sprocter/model-rocketry/(list of files, cad)

Other CAD files:
sleds/battery_cover.scad
