sprocter/model-rocketry/nene/lil-buddy/main.py

"""A script for a model rocket altimeter / accelerometer

--------------------------------------------------------------------------------
Copyright (C) 2025-2026 Sam Procter

This program is free software: you can redistribute it and/or modify it under the terms of the GNU General Public License as published by the Free Software Foundation, either version 3 of the License, or (at your option) any later version.

This program is distributed in the hope that it will be useful, but WITHOUT ANY WARRANTY; without even the implied warranty of MERCHANTABILITY or FITNESS FOR A PARTICULAR PURPOSE.  See the GNU General Public License for more details.

You should have received a copy of the GNU General Public License along with this program.  If not, see <https://www.gnu.org/licenses/>.
--------------------------------------------------------------------------------
"""

from machine import PWM, SPI, I2C, RTC, Pin, Timer, Signal
from struct import pack, unpack
from binascii import unhexlify
from neopixel import NeoPixel
from collections import deque
from micropython import const
from sys import print_exception

from bmp581 import BMP581
from adxl375 import ADXL375
from icm20649 import ICM20649
from ism330dhcx import ISM330DHCX
from mmc5983ma import MMC5983MA
from max17048 import MAX17048
from gps import GPS
from lora import SX1262
from marg import StateEstimator

import time, gc, json, vfs, machine, network, uftpd, os, deflate, esp32, random, cryptolib
import hidden_buffer as buff
import fusion_wrapper as ahrs


_MODE_INITIALIZE = const(0)
_MODE_LAUNCHPAD = const(1)
_MODE_ASCENT = const(2)
_MODE_DESCENT = const(3)
_MODE_TOUCHDOWN = const(4)
_MODE_FINISHED = const(5)
_MODE_WIFI = const(6)

_RELENG_DEVELOP_NOGPS = const(0)
_RELENG_DEVELOP = const(1)
_RELENG_TEST_NOGPS = const(2)
_RELENG_TEST = const(3)
_RELENG_RELEASE = const(4)
_RELEASE_LEVEL = const(_RELENG_RELEASE)

_SENSOR_FREQ_HZ = const(45)
_PERIOD = const(1000 / _SENSOR_FREQ_HZ)

# Number of seconds to record before launch / after touchdown
_INITIAL_FINAL_TIME_SEC = const(3)

_LAUNCHPAD_READINGS = const(_INITIAL_FINAL_TIME_SEC * _SENSOR_FREQ_HZ)

# How far above ground level / below apogee we should be before confirming mode change
if _RELEASE_LEVEL == _RELENG_RELEASE:
    _ALTITUDE_DIFFERENCE = 6
else:
    _ALTITUDE_DIFFERENCE = 1

# How many readings to consider when changing modes
_RECENT_READINGS = const(5)

# How many of those readings should be above (for liftoff) or below (for descent)
_CONFIRMATORY_READINGS = const(4)

# LED Control #
_NPXL_BRIGHTNESS = const(10)  # 1-255
_NPXL_OFF = (0, 0, 0)
_NPXL_WHT = (_NPXL_BRIGHTNESS, _NPXL_BRIGHTNESS, _NPXL_BRIGHTNESS)
_NPXL_RED = (_NPXL_BRIGHTNESS, 0, 0)
_NPXL_ORA = (_NPXL_BRIGHTNESS, _NPXL_BRIGHTNESS // 2, 0)
_NPXL_GRN = (0, _NPXL_BRIGHTNESS, 0)
_NPXL_CYA = (0, _NPXL_BRIGHTNESS, _NPXL_BRIGHTNESS)
_NPXL_BLU = (0, 0, _NPXL_BRIGHTNESS)
_NPXL_PUR = (_NPXL_BRIGHTNESS // 2, 0, _NPXL_BRIGHTNESS)

_MODE_TO_NPXL = {
    _MODE_INITIALIZE: _NPXL_WHT,
    _MODE_LAUNCHPAD: _NPXL_RED,
    _MODE_ASCENT: _NPXL_ORA,
    _MODE_DESCENT: _NPXL_GRN,
    _MODE_TOUCHDOWN: _NPXL_CYA,
    _MODE_FINISHED: _NPXL_BLU,
    _MODE_WIFI: _NPXL_PUR,
}

_GPS_CONNECTED = False

# 2M Floats is 8MiB, which is how much PSRAM we have.
# This gives us almost half an hour of data storing 25 values per reading, 45
# times a second.
_BUFFER_SIZE = const(2_000_000)
_FLOATS_PER_FRAME = const(25)
_PACK_FORMAT = const(">fffffffffffffffffffffffff")
_EMPTY_READING = (0, 0, 0)
_MAX_HIRES_ACCEL = const(15 * 9.80665)  # The sensor tops out at 16g and 9.80665
# is earth's standard gravity https://en.wikipedia.org/wiki/Standard_gravity


####################################
# BEGIN Interrupt Service Routines #
####################################


def toggle_buzzer_freq(timer: Timer) -> None:
    global p1, p2
    if p1.freq() == buzzer_freq_1:
        p1.freq(buzzer_freq_2)
        p2.freq(buzzer_freq_2)
    else:
        p1.freq(buzzer_freq_1)
        p2.freq(buzzer_freq_1)


def get_sensor_readings(timer: Timer) -> None:
    global previous_gps_read_ts, microtime_start

    microtime_start = time.ticks_us()
    timestamp = time.ticks_diff(time.ticks_ms(), launch_time_ms)
    alti.read_raw()
    accel.read_raw()
    if has_hires_accel:
        hires_accel.read_raw()
        hires_accel_buffer = hires_accel.buffer
    else:
        hires_accel_buffer = None
    # Devices burst read all their values into one buffer -- we only decode
    # what we need. So, if the accel and gyro are aliased, we should not
    # trigger a second read.
    if accel != gyro and not has_hires_accel:
        gyro.read_raw()
    mag.read_raw()

    fresh_gps = False

    if timestamp - previous_gps_read_ts > 100:
        previous_gps_read_ts = timestamp
        fresh_gps = True
        if _GPS_CONNECTED:
            gps.read_raw()
            gps.clear_buffer()  # Clear the UART Rx buffer -- otherwise it seems to fill up. Not sure if we're subtly out of sync or what.

    process_reading(
        timestamp.to_bytes(3, "little"),
        alti.buffer,
        mag.buffer,
        accel.buffer,
        hires_accel_buffer,
        gyro.buffer,
        fresh_gps,
        gps.buffer,
    )


def send_radio_message(timer: Timer) -> None:
    send_message()


def button_handler(boot_button: Pin) -> None:
    global disable_button
    if disable_button:
        return
    disable_button = True
    buzzer_timer.deinit()
    radio_timer.deinit()
    share_files()


##################################
# END Interrupt Service Routines #
##################################


def enable_buzzer() -> None:
    global p1, p2
    buzzer_timer.init(mode=Timer.PERIODIC, period=3000, callback=toggle_buzzer_freq)
    p1 = PWM(Pin(buzzer_pin_1), freq=buzzer_freq_1, duty_u16=32768)
    p2 = PWM(Pin(buzzer_pin_2), freq=buzzer_freq_1, duty_u16=32768, invert=True)


def enable_sensor_recording() -> None:
    sensor_reading_timer.init(
        mode=Timer.PERIODIC, freq=_SENSOR_FREQ_HZ, callback=get_sensor_readings
    )


def enable_radio() -> None:
    radio_timer.init(mode=Timer.PERIODIC, period=60000, callback=send_radio_message)


@micropython.native
def process_reading(
    timestamp_param: bytes,
    alti_buffer: bytearray,
    mag_buffer: bytearray,
    acc_buffer: bytearray,
    hires_acc_buffer: bytearray,
    gyro_buffer: bytearray,
    fresh_gps: bool,
    gps_buffer: bytearray,
) -> None:
    global reading_num, apogee, prev_frame_time

    timestamp = int.from_bytes(timestamp_param, "little")
    raw_altitude = alti.decode_alti(alti_buffer)
    ambient_temp = alti.decode_temp(alti_buffer)
    barometric_altitude = raw_altitude - initial_altitude

    mag_rdg = mag.decode_mag(mag_buffer)

    lores_acc_rdg = accel.decode_accel(acc_buffer)
    hires_acc_rdg = _EMPTY_READING
    if has_hires_accel:
        hires_acc_rdg = hires_accel.decode_accel(hires_acc_buffer)
        if (
            (abs(hires_acc_rdg[sens_idx[0]]) < _MAX_HIRES_ACCEL)
            and (abs(hires_acc_rdg[sens_idx[1]]) < _MAX_HIRES_ACCEL)
            and (abs(hires_acc_rdg[sens_idx[2]]) < _MAX_HIRES_ACCEL)
        ):
            acc_rdg = hires_acc_rdg
        else:
            acc_rdg = lores_acc_rdg
    else:
        acc_rdg = lores_acc_rdg

    gyro_rdg = gyro.decode_gyro(gyro_buffer)
    ahrs.update(gyro_rdg, acc_rdg, mag_rdg)
    [roll, pitch, yaw, tilt] = ahrs.get_euler()

    estimator.acceleration = acc_rdg
    estimator.altitude = barometric_altitude  # TODO: Shouldn't this be last? Should probably manually trigger computation

    if mode == _MODE_ASCENT and barometric_altitude > apogee:
        apogee = barometric_altitude
    if mode == _MODE_LAUNCHPAD or mode == _MODE_ASCENT:
        ascent_altis.append(barometric_altitude)
    elif mode == _MODE_DESCENT:
        if len(descent_altis) == 0 or timestamp - descent_altis[-1][0] >= 1000:
            descent_altis.append((timestamp, barometric_altitude))
    update_mode()

    if fresh_gps:
        gps.decode_reading(gps_buffer)
    if mode == _MODE_LAUNCHPAD:
        packed_reading = pack(
            _PACK_FORMAT,
            float(timestamp),
            sens_inv[0] * lores_acc_rdg[sens_idx[0]],  # X
            sens_inv[1] * lores_acc_rdg[sens_idx[1]],  # Y
            sens_inv[2] * lores_acc_rdg[sens_idx[2]],  # Z
            sens_inv[0] * hires_acc_rdg[sens_idx[0]],  # X
            sens_inv[1] * hires_acc_rdg[sens_idx[1]],  # Y
            sens_inv[2] * hires_acc_rdg[sens_idx[2]],  # Z
            sens_inv[0] * gyro_rdg[sens_idx[0]],
            sens_inv[1] * gyro_rdg[sens_idx[1]],
            sens_inv[2] * gyro_rdg[sens_idx[2]],
            sens_inv[0] * mag_rdg[sens_idx[0]],
            sens_inv[1] * mag_rdg[sens_idx[1]],
            mag_z_inv * mag_rdg[sens_idx[2]],
            barometric_altitude,
            gps.altitude - initial_gps_altitude,
            ambient_temp,
            float(gps.lat),
            float(gps.lon),
            tilt,
            yaw,
            pitch,
            roll,
            estimator.altitude,
            estimator.velocity,
            prev_frame_time,
        )
        ground_readings.append(packed_reading)
    elif mode == _MODE_ASCENT or mode == _MODE_DESCENT or mode == _MODE_TOUCHDOWN:
        idx_start = reading_num * _FLOATS_PER_FRAME
        buff.store(idx_start + 0, float(timestamp))
        buff.store(idx_start + 1, sens_inv[0] * lores_acc_rdg[sens_idx[0]])  # X
        buff.store(idx_start + 2, sens_inv[1] * lores_acc_rdg[sens_idx[1]])  # Y
        buff.store(idx_start + 3, sens_inv[2] * lores_acc_rdg[sens_idx[2]])  # Z
        buff.store(idx_start + 4, sens_inv[0] * hires_acc_rdg[sens_idx[0]])  # X
        buff.store(idx_start + 5, sens_inv[1] * hires_acc_rdg[sens_idx[1]])  # Y
        buff.store(idx_start + 6, sens_inv[2] * hires_acc_rdg[sens_idx[2]])  # Z
        buff.store(idx_start + 7, sens_inv[0] * gyro_rdg[sens_idx[0]])
        buff.store(idx_start + 8, sens_inv[1] * gyro_rdg[sens_idx[1]])
        buff.store(idx_start + 9, sens_inv[2] * gyro_rdg[sens_idx[2]])
        buff.store(idx_start + 10, sens_inv[0] * mag_rdg[sens_idx[0]])
        buff.store(idx_start + 11, sens_inv[1] * mag_rdg[sens_idx[1]])
        buff.store(idx_start + 12, mag_z_inv * mag_rdg[sens_idx[2]])
        buff.store(idx_start + 13, barometric_altitude)
        buff.store(idx_start + 14, gps.altitude - initial_gps_altitude)
        buff.store(idx_start + 15, ambient_temp)

        # TODO: Should probably check latNS and lonEW once this has been
        # verified to work
        buff.store(idx_start + 16, float(gps.lat))
        buff.store(idx_start + 17, float(gps.lon))

        buff.store(idx_start + 18, tilt)
        buff.store(idx_start + 19, yaw)
        buff.store(idx_start + 20, pitch)
        buff.store(idx_start + 21, roll)
        buff.store(idx_start + 22, estimator.altitude)
        buff.store(idx_start + 23, estimator.velocity)

        buff.store(idx_start + 24, prev_frame_time)

        reading_num += 1

    gc.collect()

    prev_frame_time = float(time.ticks_diff(time.ticks_us(), microtime_start))


def update_mode() -> None:
    if mode == _MODE_LAUNCHPAD and have_liftoff():
        ascent()
    elif mode == _MODE_ASCENT and started_descent():
        descent()
    elif mode == _MODE_DESCENT and touched_down():
        touchdown()


@micropython.native
def have_liftoff() -> bool:
    threshold = _ALTITUDE_DIFFERENCE
    return sum(i > threshold for i in ascent_altis) > _CONFIRMATORY_READINGS


@micropython.native
def started_descent() -> bool:
    threshold = apogee - _ALTITUDE_DIFFERENCE
    return sum(i < threshold for i in ascent_altis) > _CONFIRMATORY_READINGS


@micropython.native
def touched_down() -> bool:
    if len(descent_altis) < 5:
        return False
    min_alt = descent_altis[-1][1] - 0.1  # 10cm
    max_alt = descent_altis[-1][1] + 0.1
    for _, alti in descent_altis:
        if alti < min_alt or alti > max_alt:
            return False
    return True


def send_message() -> None:
    retries = 0  # Avoid hanging if something went wrong with the GPS

    while retries < 30 and (
        gps.buffer == None or not hasattr(gps, "valid") or gps.valid == False
    ):
        gps.clear_buffer()
        time.sleep_ms(100)
        gps.read_raw()

        if gps.buffer != None:
            gps.decode_reading(gps.buffer)

        retries += 1

    if retries >= 30 or not (hasattr(gps, "valid") and gps.valid):
        payload = pack(">fHHBHHB", 0.0, 0, 0, ord('X'), 0, 0, ord('X'))
    else:
        lat_str = gps.lat
        lat_dir = ord(gps.latNS)
        lon_str = gps.lon
        lon_dir = ord(gps.lonEW)
        lat_elems = [int(x) for x in lat_str.split(b".")]
        lon_elems = [int(x) for x in lon_str.split(b".")]
        payload_elems = [apogee] + lat_elems + [lat_dir] + lon_elems + [lon_dir]
        payload = pack(">fHHBHHB", *payload_elems)

    pad = [random.getrandbits(8), random.getrandbits(8)]
    message = encryptor.encrypt(payload + bytes(pad))

    radio.send(message)

def _update_led() -> None:
    if have_neopixel:
        neopixel[0] = _MODE_TO_NPXL[mode]
        neopixel.write()
    else:
        # The Xio ESP32Ş-Plus has a green LED on the SX1262 daughterboard and
        # an orange LED on the main board. But the orange one shares a pin with
        # the user button on the SX1262 daughterboard, so we cannot use it when
        # the button is enabled 🤦

        if mode == _MODE_INITIALIZE:
            # INITIALIZE = green LED on, rapid blinking while searching for
            # GPS. The blinking is handled by the GPS initialization loop, so
            # we just turn on the LED.
            leds[0].on()
        elif mode == _MODE_LAUNCHPAD:
            leds[0].on()  # Solid green LED means ready to launch
        elif mode in {_MODE_ASCENT, _MODE_DESCENT, _MODE_TOUCHDOWN} and len(leds) == 2:
            # ASCENT, DESCENT, TOUCHDOWN = solid orange
            leds[0].off()
            # The second entry in leds stores the pin number
            leds.append(Signal(Pin(leds[1], Pin.OUT), invert=True))
            leds[2].on()
        elif mode == _MODE_FINISHED:
            # Green LED on
            # We remove the orange LED signal; the pin will be used for
            # user-input to switch to wifi mode
            leds[0].on()
            leds[2].off()
            del leds[2]
        elif mode == _MODE_WIFI:
            # Green LED off (orange is already off)
            leds[0].off()


def _toggle_led(led_on: bool) -> None:
    if have_neopixel:
        if not led_on:
            neopixel[0] = _NPXL_OFF
        else:
            neopixel[0] = _MODE_TO_NPXL[mode]
        neopixel.write()
    else:
        leds[0](led_on)


def _init_radio(config: dict):
    global radio, encryptor

    spi_bus = 1
    baud_rate = 2_000_000
    polarity = 0
    phase = 0
    tcxo_mv = (
        3300 - 200
    )  # "TCXO voltage should always be 200 mV less than the VCC to ensure proper operation" -- 1262 datasheet, page 7
    clk = Pin(int(config["pins"]["spi_clk"]))
    mosi = Pin(int(config["pins"]["spi_mosi"]))
    miso = Pin(int(config["pins"]["spi_miso"]))
    cs = Pin(int(config["pins"]["lora_cs"]))
    irq = Pin(int(config["pins"]["lora_dio1"]))
    rst = Pin(int(config["pins"]["lora_rst"]))
    gpio = Pin(int(config["pins"]["lora_busy"]))

    frequency = int(float(config["lora"]["freq"]) * 1000)
    bandwidth = 500
    spreading_factor = 12
    coding_rate = 8
    preamble_length = 12
    if _RELEASE_LEVEL == _RELENG_RELEASE:
        tx_power = 22
    else:
        tx_power = -5
    use_CRC = False

    lora_cfg = {
        "freq_khz": frequency,
        "sf": spreading_factor,
        "bw": bandwidth,  # kHz
        "coding_rate": coding_rate,
        "preamble_len": preamble_length,
        "output_power": tx_power,  # dBm
        "crc_en": use_CRC,
    }

    radio = SX1262(
        spi=SPI(
            spi_bus,
            baudrate=baud_rate,
            polarity=polarity,
            phase=phase,
            miso=miso,
            mosi=mosi,
            sck=clk,
        ),
        cs=cs,
        busy=gpio,
        dio1=irq,
        reset=rst,
        dio3_tcxo_millivolts=tcxo_mv,
        lora_cfg=lora_cfg,
    )

    encryption_key = unhexlify(config["lora"]["key"])
    encryptor = cryptolib.aes(encryption_key, 1)


def _init_devices(config: dict) -> None:
    global accel, hires_accel, alti, gyro, mag, gps, batt_monitor, clock, _GPS_CONNECTED, has_hires_accel
    i2c = machine.I2C(scl=config["pins"]["i2c_scl"], sda=config["pins"]["i2c_sda"])
    connected_devices = i2c.scan()

    if BMP581.ADDR in connected_devices:
        alti = BMP581(i2c)
        alti.initialize()
    else:
        raise OSError(f"No altimeter connected!")

    if MMC5983MA.ADDR in connected_devices:
        mag = MMC5983MA(i2c)
        mag.initialize(config["MMC5983MA"])
    else:
        raise OSError(f"No magnetometer connected!")

    gps = GPS(
        config["pins"]["uart_tx"],
        config["pins"]["uart_rx"],
        config["system"]["gps_pmtk_cmds"],
    )
    gps.initialize()

    # ADXL375 has the widest range (±200g) so we prefer it. ICM20649 has ±30g,
    # and ISM330DHCX ±16
    if ADXL375.ADDR in connected_devices:
        accel = ADXL375(i2c)
        accel.initialize(config["ADXL375"])
    elif ICM20649.ADDR in connected_devices:
        accel = ICM20649(i2c)
        accel.initialize(config["ICM20649"])
    elif ISM330DHCX.ADDR in connected_devices:
        accel = ISM330DHCX(i2c)
        accel.initialize(config["ISM330DHCX"])
    else:
        raise OSError(f"No accelerometer connected!")

    if ISM330DHCX.ADDR in connected_devices and not isinstance(accel, ISM330DHCX):
        has_hires_accel = True
        hires_accel = ISM330DHCX(i2c)
        hires_accel.initialize(config["ISM330DHCX"])
    else:
        has_hires_accel = False

    # Both ISM330DHCX and ICM20649 have the same range, but the ISM330DHCX is
    # more accurate, so we prefer it. We also alias the object if we are using
    # the same device for the accelerometer and gyroscope.
    if ISM330DHCX.ADDR in connected_devices:
        if isinstance(accel, ISM330DHCX):
            gyro = accel
        else:
            gyro = hires_accel
            gyro.initialize(config["ISM330DHCX"])
    elif ICM20649.ADDR in connected_devices:
        if isinstance(accel, ICM20649):
            gyro = accel
        else:
            gyro = ICM20649(i2c)
            gyro.initialize(config["ICM20649"])
    else:
        raise OSError(f"No gyroscope connected!")

    _init_radio(config)

    # Even though the battery monitor is on the board, it communicates via I2C
    # so we initialize it here, rather than _init_board
    batt_monitor = MAX17048(i2c)


def _init_board(config: dict) -> None:
    global radio_timer, sensor_reading_timer, buzzer_timer, disable_button, neopixel, have_neopixel, leds

    # Clean up memory to reduce issues with fragmentation
    gc.collect()
    # Initialize our giant buffer which will hold our readings
    buff.init_buffer(_BUFFER_SIZE)

    # Initialize the status LED
    have_neopixel = config["system"]["have_neopixel"]
    if have_neopixel:
        neopixel_pin = Pin(config["pins"]["led1"], Pin.OUT)
        neopixel = NeoPixel(neopixel_pin, 1)
    else:
        leds = []
        leds.append(Signal(Pin(config["pins"]["led1"], Pin.OUT), invert=False))
        leds.append(config["pins"]["led2"])
        # Don't initialize the second LED until we need it (and de-initialize
        # it as soon as we don't) since it shares a pin with a button we need
        # to monitor
    _update_led()

    # Initialize timers
    sensor_reading_timer = Timer(0)  # Controls reading from sensors
    radio_timer = Timer(1)  # Controls radio broadcasts
    buzzer_timer = Timer(2)  # Controls the changing pitch of the buzzer

    # Initialize the user button and register its handler
    user_button = Pin(config["pins"]["button"], Pin.IN, Pin.PULL_UP)
    user_button.irq(trigger=Pin.IRQ_FALLING, handler=button_handler)
    disable_button = False

    # Mount the filesystem so we can read the config json file and
    # (after touchdown) write the recorded data to flash
    vfs.mount(vfs.VfsLfs2(bdev, readsize=2048, progsize=256, lookahead=256, mtime=False), "/")  # type: ignore


def initialize():
    global mode, reading_num, radio, initial_altitude, apogee, launch_time_ms, debounce_time, ground_readings, ascent_altis, descent_altis, init_time, estimator, previous_gps_read_ts, clock, _GPS_CONNECTED, initial_gps_altitude, initial_batt_soc, initial_mcu_temp, buzzer_pin_1, buzzer_pin_2, buzzer_freq_1, buzzer_freq_2, prev_frame_time, sens_idx, sens_inv, mag_z_inv

    mode = _MODE_INITIALIZE

    init_time = time.ticks_ms()
    launch_time_ms = init_time  # launch time will be reset when liftoff is detected
    prev_frame_time = 0

    with open("/config.json", "r") as f:
        config = json.loads(f.read())

    _init_board(config)

    initial_mcu_temp = esp32.mcu_temperature()

    _init_devices(config)

    if config["system"]["have_batt_mon"]:
        initial_batt_soc = batt_monitor.charge_percent
    else:
        initial_batt_soc = -1

    estimator = StateEstimator(
        _PERIOD,
        alti.error,
        accel.error,
        config["orient"]["transpose"],
        config["orient"]["invert"],
    )

    # Initialization parameters for the AHRS / "Fusion" module
    gain = 0.4
    gyro_range = 4000.0 # Consider setting to 0 to disable this -- if we exceed 98% of the gyro range, the AHRS resets, which disables accelerometer rejection. That feature is extremely necessary under the significant, sustained acceleration and deceleration experienced by a rocket.
    accelerometer_reject = 10.0
    magnetometer_reject = 10.0
    rejection_timeout = 10.0  # Go higher? Like 15?
    declination = -9.38333  # Declination in degrees for PSC Launch site
    if config["orient"]["transpose"] == [2, 1, 0]:
        alignment = 1
    elif config["orient"]["transpose"] == [2, 0, 1]:
        alignment = 2
    else:
        raise LookupError(
            f"Unsupported sensor orientation: {config["orient"]["transpose"]}"
        )
    ahrs.init_ahrs(
        _SENSOR_FREQ_HZ,
        gain,
        gyro_range,
        accelerometer_reject,
        magnetometer_reject,
        rejection_timeout,
        declination,
        alignment,
    )

    # Adjust for sensor mounting constraints
    sens_idx = config["orient"]["transpose"]
    sens_inv = [-1 if x else 1 for x in config["orient"]["invert"]]
    # The MMC5983 inverts its Z axis, weirdly
    mag_z_inv = -1 * sens_inv[2] if isinstance(mag, MMC5983MA) else sens_inv[2]

    reading_num = 0  # _LAUNCHPAD_READINGS + 1
    alti.read_raw()
    initial_altitude = alti.decode_alti(alti.buffer)
    apogee = 0.0

    buzzer_pin_1 = config["pins"]["buzzer1"]
    buzzer_pin_2 = config["pins"]["buzzer2"]
    buzzer_freq_1 = config["system"]["buzzer_freq_1"]
    buzzer_freq_2 = config["system"]["buzzer_freq_2"]

    npxl_on = True

    ground_readings = deque([], _LAUNCHPAD_READINGS)
    ascent_altis = deque([], _RECENT_READINGS)
    descent_altis = deque([], _RECENT_READINGS)

    led_on = True

    if _RELEASE_LEVEL == _RELENG_DEVELOP_NOGPS or _RELEASE_LEVEL == _RELENG_TEST_NOGPS:
        wait_for_gps = False
    else:
        wait_for_gps = True
    while wait_for_gps and (
        gps.buffer == None or not hasattr(gps, "valid") or gps.valid == False
    ):
        _toggle_led(led_on)

        led_on = not led_on

        gps.clear_buffer()
        time.sleep_ms(100)
        gps.read_raw()

        if gps.buffer != None:
            gps.decode_reading(gps.buffer)

    if hasattr(gps, "valid") and gps.valid == True:
        _GPS_CONNECTED = True
        clock = RTC()
        clock.init(
            (
                gps.year,
                gps.month,
                gps.day,
                gps.hour,  # Record the timestamp in UTC, handle timezeones elsewhere
                gps.minute,
                gps.second,
                0,  # microsecond, ignored (?)
                0,  # tzinfo, ignored
            )
        )
        initial_gps_altitude = gps.altitude
    else:
        initial_gps_altitude = 0
        _GPS_CONNECTED = False

    gc.collect()
    gps.clear_buffer()
    previous_gps_read_ts = time.ticks_diff(time.ticks_ms(), init_time)
    enable_sensor_recording()
    gc.disable()

    mode = _MODE_LAUNCHPAD
    _update_led()


def ascent() -> None:
    global launch_time_ms, previous_gps_read_ts, launch_time_ymdwhms, mode, disable_button
    # Nothing really to do here -- sensors are already on, and the switch to using the PSRAM buffer is handled by the process_reading function
    launch_time_ms = time.ticks_ms()
    previous_gps_read_ts = -101  # Force a GPS read next period
    if _GPS_CONNECTED:
        launch_time_ymdwhms = clock.datetime()
    disable_button = True
    mode = _MODE_ASCENT
    _update_led()


def descent() -> None:
    global mode
    mode = _MODE_DESCENT
    _update_led()
    if _RELEASE_LEVEL == _RELENG_RELEASE:
        enable_buzzer()


def _build_header_str() -> str:
    with open("/config.json", "r") as f:
        config = json.loads(f.read())

    name_hdr_str = config["system"]["name"]
    placeholder_str = ""  # We need a blank entry for the template to work out, something else can go here later if need be
    if _GPS_CONNECTED:
        year = launch_time_ymdwhms[0]
        month = launch_time_ymdwhms[1]
        day = launch_time_ymdwhms[2]
        hour = launch_time_ymdwhms[4]
        minute = launch_time_ymdwhms[5]
        second = launch_time_ymdwhms[6]
        date_hdr_str = (
            f"{year}-{month:02d}-{day:02d}T{hour:02d}:{minute:02d}:{second:02d}Z"
        )
    else:
        date_hdr_str = "No Date"
    if config["system"]["have_batt_mon"]:
        final_batt_soc = batt_monitor.charge_percent
    else:
        final_batt_soc = -1
    batt_hdr_str = f"Batt % (Start),{initial_batt_soc},Batt % (End),{final_batt_soc}"
    mcu_hdr_str = (
        f"MCU Temp (Start),{initial_mcu_temp},MCU Temp (End),{esp32.mcu_temperature()}"
    )

    label_hdr_str = "time (ms), acc_x (m/s^2), acc_y (m/s^2), acc_z (m/s^2), h_acc_x (m/s^2), h_acc_y (m/s^2), h_acc_z (m/s^2), gyro_x (dps), gyro_y (dps), gyro_z (dps), mag_x (μT), mag_y (μT), mag_z (μT), baro_alt (m), gps_alt (m), temp (c), lat (ddmm.mmmm), lon(ddmm.mmmm), est_tilt (deg), est_yaw (deg), est_pitch (deg), est_roll(deg), est_alt (m), est_speed(m/s), prev_frame_time (μs)"

    return f"{name_hdr_str},{placeholder_str},{date_hdr_str},{batt_hdr_str},{mcu_hdr_str},\n{label_hdr_str}\n"


def _write_data() -> None:
    time_offset_ms = time.ticks_diff(launch_time_ms, init_time)
    adjusted_ground_readings = []
    while len(ground_readings) > 0:
        entry = ground_readings.popleft()
        unpacked = list(unpack(_PACK_FORMAT, entry))
        unpacked[0] -= time_offset_ms
        adjusted_ground_readings.append(pack(_PACK_FORMAT, *unpacked))

    header_str = _build_header_str()

    if _RELEASE_LEVEL == _RELENG_RELEASE:
        # Expect filenames of the form 'launch-XXXX.csv'
        prev_launches = sorted(
            list(
                filter(
                    lambda y: y.startswith("launch-") and y.endswith(".csv.gz"),
                    os.listdir(),
                )
            )
        )
        if len(prev_launches) == 0:
            launch_num = 1
        else:
            launch_num = int(prev_launches[-1][-11:-7]) + 1

        with open(f"launch-{launch_num:04d}.csv.gz", "wb") as f:
            with deflate.DeflateIO(f, deflate.GZIP, 8) as d:
                d.write(header_str.encode("utf-8"))
                for packed_reading in adjusted_ground_readings:
                    d.write(
                        (
                            ", ".join(
                                str(x) for x in unpack(_PACK_FORMAT, packed_reading)
                            )
                            + "\n"
                        ).encode("utf-8")
                    )
                reading = [0.0] * _FLOATS_PER_FRAME
                for i in range(reading_num):
                    for j in range(_FLOATS_PER_FRAME):
                        reading[j] = buff.retrieve_from(i * _FLOATS_PER_FRAME + j)
                    d.write((", ".join(str(x) for x in reading) + "\n").encode("utf-8"))
    else:
        if header_str is not None:
            print(header_str, end="")
        for packed_reading in adjusted_ground_readings:
            print(", ".join(str(x) for x in unpack(_PACK_FORMAT, packed_reading)))
        reading = [0.0] * _FLOATS_PER_FRAME
        for i in range(reading_num):
            for j in range(_FLOATS_PER_FRAME):
                reading[j] = buff.retrieve_from(i * _FLOATS_PER_FRAME + j)
            print(", ".join(str(x) for x in reading))


def touchdown() -> None:
    global mode, disable_button

    mode = _MODE_TOUCHDOWN
    _update_led()

    sensor_reading_timer.deinit()
    gc.enable()
    gc.collect()

    _write_data()  # Get the data safely written first

    # Note that we can't turn the radio on until the sensors are off because it takes so long (~400ms) to send a message

    send_message()  # Send a message as soon as we're done with file i/o
    enable_radio()  # Send future messages once per minute

    disable_button = False

    if not have_neopixel:
        boot_button = Pin(leds[1], Pin.IN, Pin.PULL_UP)

    mode = _MODE_FINISHED
    _update_led()


def share_files() -> None:
    """Turns on wifi and an FTP server

    This will turn the device into a Wi-Fi access point (using the SSID and password from the file "config.json"), and then turn on a FTP server (no username or password).
    """

    global mode
    mode = _MODE_WIFI
    _update_led()
    with open("/config.json", "r") as f:
        config = json.loads(f.read())
    gc.collect()
    ap_if = network.WLAN(network.AP_IF)
    time.sleep_ms(10)  # Give things a chance to settle
    ap_if.active(True)
    ap_if.config(ssid=config["wifi"]["name"], security=3, key=config["wifi"]["key"])
    while ap_if.active() == False:
        time.sleep_ms(10)  # Give things a chance to settle
    gc.collect()
    uftpd.start(splash=False)
    while True:
        time.sleep(5)


try:
    initialize()
    if _RELEASE_LEVEL == _RELENG_DEVELOP or _RELEASE_LEVEL == _RELENG_DEVELOP_NOGPS:
        time.sleep(5)
        ascent()
        time.sleep(5)
        descent()
        time.sleep(5)
    while True:
        time.sleep(5)
except Exception as err:
    # If something goes wrong after launch but before we're done, try and
    # save what data we have and turn on the buzzer / radio
    if mode == _MODE_ASCENT or mode == _MODE_DESCENT or mode == _MODE_TOUCHDOWN:
        touchdown()
    # And then log the error (to a file or StdErr if we're testing)
    if _RELEASE_LEVEL == _RELENG_RELEASE:
        with open(f"error-log.txt", "at") as f:
            print_exception(err, f)
    else:
        print_exception(err)
