sprocter/model-rocketry/nene/lil-buddy/drivers/mmc5983ma.py

"""A very simple driver for the MMC5983MA Magnetometer

--------------------------------------------------------------------------------
Copyright (C) 2026 Sam Procter

This program is free software: you can redistribute it and/or modify it under the terms of the GNU General Public License as published by the Free Software Foundation, either version 3 of the License, or (at your option) any later version.

This program is distributed in the hope that it will be useful, but WITHOUT ANY WARRANTY; without even the implied warranty of MERCHANTABILITY or FITNESS FOR A PARTICULAR PURPOSE.  See the GNU General Public License for more details.

You should have received a copy of the GNU General Public License along with this program.  If not, see <https://www.gnu.org/licenses/>.
--------------------------------------------------------------------------------
"""

from machine import I2C
from struct import unpack
import time

# Page and section numbers refer to the datasheet

_MMC5983MA_CHIPID = const(0x2F)  # pg 16, Product ID1
_MMC5983MA_XOUT0 = const(0x00)  # pg 13, Register Map
_MMC5983MA_CTRL0 = const(0x09)  # pg 14
_MMC5983MA_CTRL1 = const(0x0A)  # pg 15
_MMC5983MA_CTRL2 = const(0x0B)  # pg 15

_EXPECTED_DEVICE_ID = const(48)  # pg 16, Product ID1

# Hard iron (HI) and Soft iron (SI) offsets
# Calculate these once you have your board built / mounted using the
# print_mmc5983_offsets() function in the utilities.py file
# _X_HI_OFFSET = const(5784.0)
# _Y_HI_OFFSET = const(-1682.0)
# _Z_HI_OFFSET = const(-2449.5)
# _X_SI_OFFSET = const(0.09523398)
# _Y_SI_OFFSET = const(-0.3274871)
# _Z_SI_OFFSET = const(-0.22487582)

# Page 2 of datasheet gives 16384 "Counts"/G[auss].
# 1G = .0001T, so .01G = 1.0E-6T, so (16384/10000)*100 = 163.84 
_MICROTESLA_SCALE_FACTOR = const(163.84)

class MMC5983MA:

    ADDR = const(0x30)

    def __init__(self, i2c: I2C) -> None:
        self.i2c = i2c

        self.x_hi_offset = 0.0 
        self.y_hi_offset = 0.0 
        self.z_hi_offset = 0.0 
        self.x_si_offset = 1.0 
        self.y_si_offset = 1.0 
        self.z_si_offset = 1.0 

        # Mag values are three 18 bit floats split across 7 bytes 😑
        self.buffer = bytearray(7)

        # "Local" offsets, set automatically during initialization using the chip's SET and RESET functionality
        self._x_offset = 0
        self._y_offset = 0
        self._z_offset = 0

    def _calculate_offsets(self) -> None:
        """Calculate the device's local offsets and store them

        This implements the procedure (described on pg 18 of the datasheet) for calculating the three axes' offsets. It modifies the _x|y|z_offset variables, which are used in the _decode_mag_internal function.
        """
        # "Set" operation
        # 0 0 0 0 1 0 0 0
        self.i2c.writeto_mem(ADDR, _MMC5983MA_CTRL0, b"\x08")
        time.sleep_us(1)  # Datasheet says 500ns, we'll give a little extra

        # Trigger reading
        self.i2c.writeto_mem(ADDR, _MMC5983MA_CTRL0, b"\x01")
        time.sleep_ms(10)
        self.read_raw()
        (x1, y1, z1) = self._decode_mag_internal(self.buffer)

        # "Reset" operation
        # 0 0 0 1 0 0 0 0
        self.i2c.writeto_mem(ADDR, _MMC5983MA_CTRL0, b"\x10")
        time.sleep_us(1)  # Datasheet says 500ns, we'll give a little extra

        # Trigger reading
        self.i2c.writeto_mem(ADDR, _MMC5983MA_CTRL0, b"\x01")
        time.sleep_ms(10)
        self.read_raw()
        (x2, y2, z2) = self._decode_mag_internal(self.buffer)

        self._x_offset = (x1 + x2) / 2
        self._y_offset = (y1 + y2) / 2
        self._z_offset = (z1 + z2) / 2

    def initialize(self, offsets : dict) -> None:
        if ADDR not in self.i2c.scan():
            raise OSError(f"MMC5983MA not found at {ADDR}")
        actual_device_id = unpack(
            "<B", self.i2c.readfrom_mem(ADDR, _MMC5983MA_CHIPID, 1)
        )[0]
        if actual_device_id != _EXPECTED_DEVICE_ID:
            raise OSError(f"MMC5983MA has incorrect device id {actual_device_id}")

        # Reset the chip, take measurements for 8ms (100Hz B/W)
        # 1 00 00 0 0 0
        self.i2c.writeto_mem(ADDR, _MMC5983MA_CTRL1, b"\x80")
        # Datasheet says power on time is 10ms, we'll give a little extra
        time.sleep_ms(20)

        self._calculate_offsets()

        # Enable Auto Set/Reset
        # 0 0 1 0 0 0 0 0
        # This is a neat feature but it 1) flips the signs from what I get from
        # a reference implementation and 2) requires re-establishing the
        # offsets. So I don't know how to use it in my time-constrained setup
        # self.i2c.writeto_mem(ADDR, _MMC5983MA_CTRL0, b"\x20")

        # Enable periodic settings, set every time*, enable continuous mode, Continuous frequency = 50hz
        # * Since we're not using auto set / reset, I don't believe this affects anything.
        # 1 000 1 100
        self.i2c.writeto_mem(ADDR, _MMC5983MA_CTRL2, b"\x8c")

        time.sleep_ms(10)  # Block until first reading can be taken, they take 8ms

        self.x_hi_offset = offsets["X_HI_OFFSET"]
        self.y_hi_offset = offsets["Y_HI_OFFSET"] 
        self.z_hi_offset = offsets["Z_HI_OFFSET"] 
        self.x_si_offset = offsets["X_SI_OFFSET"]
        self.y_si_offset = offsets["Y_SI_OFFSET"]
        self.z_si_offset = offsets["Z_SI_OFFSET"]

    def read_raw(self) -> None:
        self.i2c.readfrom_mem_into(ADDR, _MMC5983MA_XOUT0, self.buffer)

    @micropython.native
    def _decode_mag_internal(self, reading: bytearray) -> tuple[float, float, float]:
        """Decode a reading from the magnetometer into its internal representation

        This decodes the supplied magnetometer reading into an internal / unscaled representation. This is useful for maintaining precision, but is probably of less interest to users who may want SI or other units.

        :param bytearray reading: The raw bytes retrieved from the magnetometer
        :returns: The strength of the sensed X, Y, and Z magnetic fields 
        :rtype: tuple[float, float, float]
        """
        x_raw = reading[0] << 10 | reading[1] << 2 | reading[6] >> 6
        y_raw = reading[2] << 10 | reading[3] << 2 | ((reading[6] >> 4) & 0x03)
        z_raw = reading[4] << 10 | reading[5] << 2 | ((reading[6] >> 2) & 0x03)
        x_adj = (x_raw - self._x_offset - self.x_hi_offset) * self.x_si_offset
        y_adj = (y_raw - self._y_offset - self.y_hi_offset) * self.y_si_offset
        z_adj = (z_raw - self._z_offset - self.z_hi_offset) * self.z_si_offset
        return (x_adj, y_adj, z_adj)

    @micropython.native
    def decode_mag(self, reading: bytearray) -> tuple[float, float, float]:
        """Decode a reading from the magnetometer into microteslas

        This decodes the supplied magnetometer reading into microteslas.
        
        :param bytearray reading: The raw bytes retrieved from the magnetometer
        :returns: The strength of the sensed X, Y, and Z magnetic fields 
        :rtype: tuple[float, float, float]
        """
        return tuple(x/_MICROTESLA_SCALE_FACTOR for x in self._decode_mag_internal(reading))
