sprocter/model-rocketry/(commit log)

2024-11-11 Add fancier accelerometer API
2024-11-12 Move pico files to subdir
2024-11-23 Added threaded file writes
2024-11-23 Add multi-launch and LED support
    and break i2c???
2024-11-24 Seems to be working
    As long as you hard reset it after each run 😒
    [main.py]
2024-11-24 Add shutdown button support
2024-11-26 Documentation and cleanup pass
    [launch1.csv, launch2.csv]
2024-11-26 Revert "Documentation and cleanup pass"
    This reverts commit f84042416e3f700266a816f51e3432b3d0dcf8dc.
    Accidentally pushed binary / output data.
    [launch1.csv, launch2.csv]
2024-11-27 Implemented pressure translation
2024-11-30 Cleanup and dim the LEDs
2024-12-01 Add FIFO and accel config
    Remove altimeter since ICP-10125 doesn't support FIFO 😪
2024-12-04 (Basic) file I/O, cleanup, calibration
2024-12-10 Ported to the ESP32-S3 (QT PY)
2024-12-12 Add timestamps for accelerometer data
2024-12-13 Add altimeter printing to tera
2025-01-11 A couple more cleanup things I missed
2025-05-24 Add power saving flag and accelerometer options
2025-05-25 Add "resolution" to pico script
2025-05-26 Save power in low res, tweak tera
2025-05-27 Put the accelerometer stuff in its own class
2025-05-31 split the drivers out of the on-device python file
2025-06-04 Documentation pass on pico-main
2025-06-19 Added docstrings to altimeter driver
2025-06-19 Add docstrings to accelerometer driver
2025-07-01 Add docstrings to accelerometer decoder
2025-07-16 Fix two bugs with accelerometer values
    1. The accelerometer is super, super noisy at 500hz so turn that down to ~100hz. Higher resolutions now increase number of samples averaged.
    2. The acceleration values were using the wrong y axis in the displayed graphs.
    [icm20649.py]
2025-07-16 Fix a couple crashes, move wifi/ftp to its own function
    [icm20649.py]
2025-07-18 Add brief printed output to tera script
2025-09-14 Add partial driver for ADXL375 accelerometer
2025-09-14 Add offsets to accelerometer
2025-09-16 Add driver for BMP581 pressure sensor
2025-09-18 Switch to using BMP581 and ADXL375
2025-09-21 Fix wifi / file sharing
    [main.py]
2025-09-25 Fix buzzer with new pin assignments
    [main.py]
2025-11-05 Fix a number of bugs
    [main.py, utilities.py]
2025-11-05 Fix several more bugs
    [main.py]
2025-12-20 initial sketch of LOC 4inch sled
    [4in-LOC.scad]
2025-12-22 Add ICM20649 driver
2025-12-22 add gyro recording
2025-12-27 initial implementation of kalman filter
2025-12-27 Update with dimensions of payload + coupler
    [4in-LOC.scad]
2025-12-30 Sketch of GPS driver using UART and regex
2025-12-30 Add IMU using external fusion library
2026-01-01 Tweak BT-65 Sled
    [045mm (BT-65).scad]
2026-01-04 Add initial mmc5983ma driver, needs calibration function
2026-01-04 Add magnetometer calibration
2026-01-09 Update BMP581 driver to report temp and follow new style
2026-01-11 Work on re-enabling launchpad mode and CSV printing
2026-01-18 Update the BT-65 sled to fit a battery + radio
    [045mm (BT-65).scad]
2026-01-19 fix: split into two objects for printability
    [045mm (BT-65).scad]
2026-02-07 Minor tweaks to drivers and utilities cleanup
2026-02-07 Add radio and buzzer on FeatherS3D, start shift to 45Hz
    [main.py]
2026-02-07 Update drivers, move to 45Hz rate
2026-02-21 Fix bug with GPS / use 8601 for timestamp
    [main.py]
2026-02-21 Move drivers to their own subdirectory
2026-02-21 rename LOC 4in sled
    [102mm (LOC 4in).scad]
2026-02-22 Bugfix for GPS coords in LoRa messages
    [main.py]
2026-02-25 Re-enable / clean update_mode() and fix gps hang
    [main.py]
2026-02-26 Fix file compression, add more TODOs
    [main.py]
2026-02-28 Fix a couple bugs and check off some TODOs
    [main.py]
2026-02-28 Fix a handful of issues encountered in pre-launch testing
    [main.py, pa1010.py]
2026-02-28 Fix issue where no gps blocks file i/o 😱
    [main.py]
2026-03-08 Tweak sizing and add stabilizer to 102mm sled
    [102mm (LOC 4in).scad]
2026-03-08 Slight shrink on 102mm sled stabilizer width
    [102mm (LOC 4in).scad]
2026-03-14 Tweak design of LOC-4 sled based on test print
    [102mm (LOC 4in).scad]
2026-03-21 A few formatting and bugfix tweaks
    [main.py, mmc5983ma.py, pa1010.py]
2026-03-27 Fix GPS bug and wrap main call in try/except
    [main.py]
2026-03-28 Refactor utility methods to stand alone and add lipo charge monitor
2026-03-29 A few last minute bugfixes
    [main.py]
2026-03-31 Re-enable battery logging and other last-minute cuts
2026-04-01 Remove calls to schedule() since they're not needed with soft interrupts
2026-04-12 Add voltage to MAX17048 and update bigbuddy
2026-04-12 Add files and instructions for customizations of micropython
    [partitions_nene.csv]
2026-04-15 Add driver for ISM330DHCX
2026-04-15 Fix bug in ICM20649 driver and remove 'decode_reading' method
    [icm20649.py]
2026-04-19 Tweak driver structure; improve sensor selection logic
2026-04-19 Add battery cover for the sleds
    [battery_cover.scad]
2026-04-26 Switch to release, clean up print statements
2026-04-28 Remove CPU overclock
    Not needed after the recent schedule() removals / performance tweaks, wastes power, generates heat.
2026-05-02 Remove battery modifications to 45mm sled
    [045mm (BT-65).scad]
2026-05-04 Refactor drivers to use config-supplied offsets
2026-05-07 Add WiFi/FTP and buzzer tests
    [generate-config.py]
2026-05-22 Fix a handful of issues with the ADXL375 driver and config-generator
    [adxl375.py, generate-config.py]
2026-05-23 Tweak position of strap slot on battery cover
    [battery_cover.scad]
2026-05-23 Uncomment mistakenly disabled code
    [generate-config.py]
2026-05-25 Initial sketch of BT-50 sled
    [025mm (BT-50).scad]
2026-06-18 Update BT-50 for better sensor position and stronger MCU bond
    [025mm (BT-50).scad]
2026-07-01 Add some bars over the radio for more stability
    [025mm (BT-50).scad]
2026-07-02 Adjust MCU brace and tweak cutouts for QWIIC and B2B connectors
    [025mm (BT-50).scad]
2026-07-02 Expand README with example outputs and Nene explanation
    [example-output.csv]
2026-07-02 Remove B2B connector cutout, further narrow coupler and sled
    [025mm (BT-50).scad]
2026-07-03 Strengthen a couple weak spots and relax top brace fit
    [025mm (BT-50).scad]
2026-07-03 Left some changes out of previous commit
    [025mm (BT-50).scad]
2026-07-04 Add cable routing slots
    [025mm (BT-50).scad]
2026-07-04 Add battery voltage to charge monitor utility function
2026-07-05 First attempt at sensor orientation for the smaller computer
2026-07-07 Initial commit of 31mm (So Long) sled
    [031mm.scad]
2026-07-08 Fix a couple bugs with the AHRS configuration
    [generate-config.py, marg.py]
2026-07-09 Disable UART REPL due to shared pins used by GPS on Xiao ESP32S3 Plus
2026-07-10 Bevel the edges of the battery cover and 31mm sled for easier fit
    [031mm.scad, battery_cover.scad]
2026-07-10 Shrink one of the arms that bumps into a chip
    [031mm.scad]
2026-07-11 Shorten battery cover pegs and slightly reduce thickness
    [battery_cover.scad]
2026-08-01 Tweak NeoPixel status LED
2026-08-06 Add better frame time tracking
2026-08-08 Store high resolution accelerometer data
2026-08-09 Switch the ICM20649 to 500dps sensitivity
2026-08-10 Fix orientation of sensors in output
    [main.py]
2026-08-10 Handle bug in timestamps at launch
    [pc-utilities.py]
2026-08-11 Reduce ISM330DHCX Gyro range to 500 dps
2026-08-11 Use hi-resolution accelerometer readings when < 15g
2026-08-16 Fix silly? nasty? logic error in AHRS
    [marg.py]
2026-08-16 Reduce CPU / GC overhead of yesterday's bugfix
    [marg.py]
2026-09-07 Use gyro bias feature
2026-09-08 Fix double-sign-flip bug in spin graph
    [pc-utilities.py]
2026-09-12 Fix a minor bug and remove accidentally committed testing code
    [main.py, pc-utilities.py]
2026-09-20 Switch LoRa libraries and config, encrypt LoRa msgs
2026-09-22 Rewrite 45mm sled to fit in louder beeper
    [045mm (BT-65).scad]
2026-09-22 Fix wrong labels in motion plot
    [pc-utilities.py]
2026-09-29 Switch to manifest-based build style
    [partitions_nene.csv]
2026-09-29 Tweak margins on 31mm sled for more room around mounting holes
    [031mm.scad]
2026-10-14 Make buzzer pin and freq configurable, update config generator
2026-11-01 Revert gyroscope range changes -- set to 4000dps
2026-11-04 Additional fixes related to widening gyro range
